vdumoulin/espresso-shot/(commit log)

2021-03-01 Add Arduino source code, Python script, and Jupyter Notebook
2021-03-01 Calibrate basket thermistor
2021-03-04 Fix compilation errors, make better use of State enum
    [espresso-shot.ino, espresso-shot.py]
2021-03-04 Add calibration section
2021-03-04 Add circuit diagram
2021-03-04 Change fan pin
2021-03-04 Add missing ground wire in circuit diagram
2021-03-05 Improve circuit diagram
2021-03-06 Fix errors raised when compiling for Arduino Nano 33 BLE
    [constants.h, data_structures.h, espresso-shot.py, functions.cpp, functions.h]
2021-03-07 Make circuit 3.3V-compatible
2021-03-07 Switch to schematic view
2021-03-07 Refactor code to be primarily resistance-based
2021-03-08 Fix serial communication issue
    [data_structures.h, espresso-shot.py, functions.cpp]
2021-03-08 Move Python functions to utils module, fix MockSerial
    [espresso-shot.py, utils.py]
2021-03-08 Fix record mode bug
    [espresso-shot.py]
2021-03-08 Add calibration script
2021-03-08 Recalibrate group thermistor
2021-03-09 Fix bug where temperature constants were ignored
    [constants.h, functions.cpp]
2021-03-09 Move calibration initialization into its own function
2021-03-10 Update calibration instructions
2021-03-10 Switch to TaskScheduler library, improve resistance measurement code
2021-03-13 Switch to Button library for switch management, swap potentiometer for two push buttons to control target group temperature
    [constants.h, espresso-shot.ino, functions.cpp, functions.h]
2021-03-17 Update circuit diagram
